Osservatorio-LISA/Telescope-Proxy/cassinipcb_final/tesi cassini/production/bom.csv

Designator | Footprint | Quantity | Value | LCSC Part #
C_VIN1 | CP_Radial_D6.3mm_P2.50mm | 1 | 220u
C_VIN2 | C_Disc_D4.3mm_W1.9mm_P5.00mm | 1 | 220p
J1, J2 | PinSocket_1x15_P2.54mm_Vertical | 2 | Conn_01x15_Socket
J10 | PinHeader_1x03_P2.54mm_Vertical | 1 | GPIO26
J11 | PinHeader_1x03_P2.54mm_Vertical | 1 | GPIO27
J3 | ScrewTerminal2Pin | 1 | Power IN
J4 | PinHeader_1x05_P2.54mm_Vertical | 1 | Additional GPIO
J5 | PinHeader_1x04_P2.54mm_Vertical | 1 | Seriale232
J6 | PinHeader_1x04_P2.54mm_Vertical | 1 | I2C
J7 | PinHeader_1x06_P2.54mm_Vertical | 1 | SPI
J9 | PinHeader_1x03_P2.54mm_Vertical | 1 | GPIO25
R1 | R_Axial_DIN0204_L3.6mm_D1.6mm_P5.08mm_Horizontal | 1 | 10k
SW1 | PinHeader_1x02_P2.54mm_Vertical | 1 | SW_SPST
SW2 | PinHeader_1x02_P2.54mm_Vertical | 1 | SW_RST
