Osservatorio-LISA/Telescope-Proxy/cassinipcb_final/tesi cassini/tesi cassini.kicad_pcb

## KiCad design cassinipcb_final/tesi cassini/tesi cassini.kicad_pcb (2026-10-16)

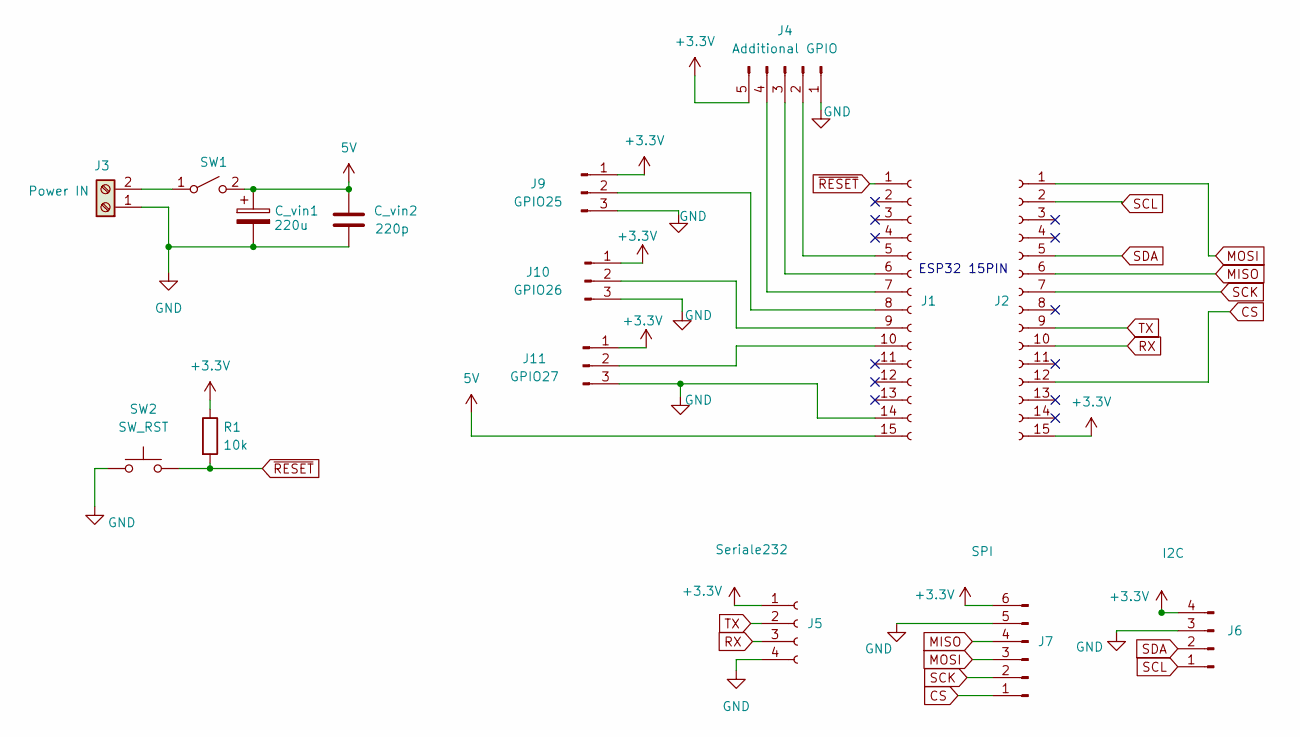
[picture p21: schematic tesi cassini.kicad_sch]

Parts:
C_vin1: 220u; CP_Radial_D6.3mm_P2.50mm
C_vin2: 220p; C_Disc_D4.3mm_W1.9mm_P5.00mm
J1, J2: Conn_01x15_Socket; PinSocket_1x15_P2.54mm_Vertical
J3: Power IN; ScrewTerminal2Pin
J4: Additional GPIO; PinHeader_1x05_P2.54mm_Vertical
J5: Seriale232; PinHeader_1x04_P2.54mm_Vertical
J6: I2C; PinHeader_1x04_P2.54mm_Vertical
J7: SPI; PinHeader_1x06_P2.54mm_Vertical
J9: GPIO25; PinHeader_1x03_P2.54mm_Vertical
J10: GPIO26; PinHeader_1x03_P2.54mm_Vertical
J11: GPIO27; PinHeader_1x03_P2.54mm_Vertical
R1: 10k; R_Axial_DIN0204_L3.6mm_D1.6mm_P5.08mm_Horizontal
SW1: SW_SPST; PinHeader_1x02_P2.54mm_Vertical
SW2: SW_RST; PinHeader_1x02_P2.54mm_Vertical

Connections:
5V: C_vin1.1, C_vin2.2, J1.15, SW1.2 (B)
+3.3V: J2.15, J4.5, J5.1, J6.4, J7.6, J9.1, J10.1, J11.1, R1.1
CS: J2.12, J7.1
GND: C_vin1.2, C_vin2.1, J1.14, J3.1, J4.1, J5.4, J6.3, J7.5, J9.3, J10.3, J11.3, SW2.1
MISO: J2.6, J7.4
MOSI: J2.1, J7.3
unnamed: J1.5, J4.2
unnamed: J1.6, J4.3
unnamed: J1.7, J4.4
unnamed: J1.8, J9.2
unnamed: J1.9, J10.2
unnamed: J1.10, J11.2
unnamed: J3.2, SW1.1 (A)
RX: J2.10, J5.3
SCK: J2.7, J7.2
SCL: J2.2, J6.1
SDA: J2.5, J6.2
TX: J2.9, J5.2
~RESET: J1.1, R1.2, SW2.2

Notes on the sheet:
ESP32 15PIN

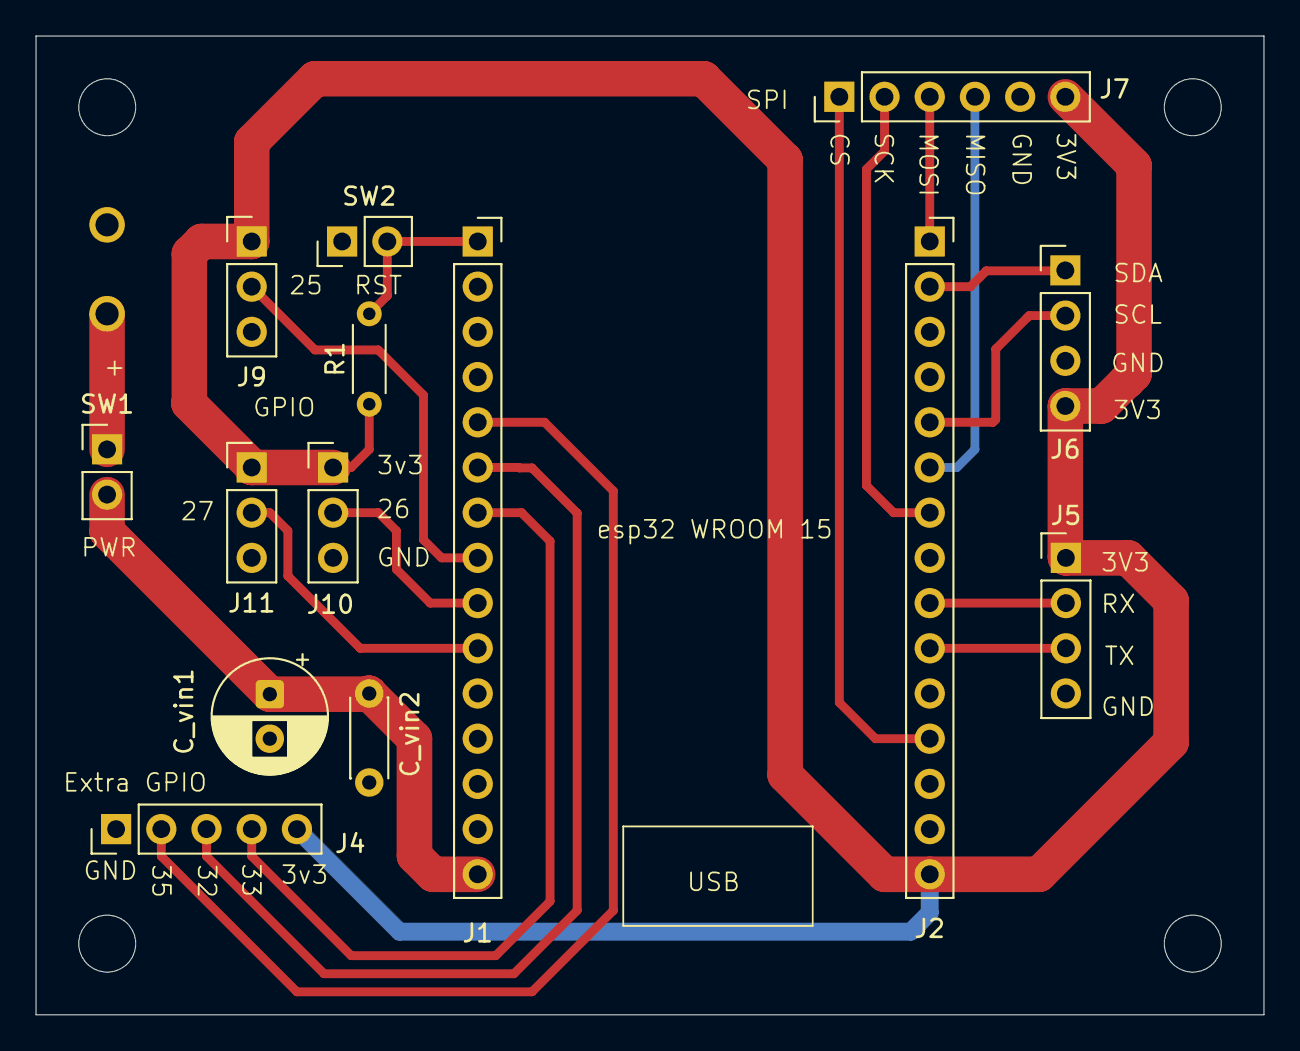
[picture p22: board tesi cassini.kicad_pcb from above]

Board: 2 copper layers, 69.0 x 55.0 mm, 15 parts (1 on the bottom side), 19 nets.
